afterSuperSam/TinyML-ESP32-CO2Prediction/docs/System.md

# 系统 System

## 当前能力与边界

当前源码 v1.12.1 使用 ESP32-S3、2.4 英寸横向触摸屏与 SCD41；上次板端验收版本为 v1.12.0。已实现实时读数、分钟历史、CO₂ TinyML 预测及持久化开关、双情景曲线、触摸校准、环境分类、LittleFS 记录和 USB 导出。

当前运行入口为实时采集，界面没有实测/回放模式切换按钮。保留的回放模块用于已有逻辑检查，不代表系统会在传感器故障时自动改用演示数据。

控制页只预览目标档位；尚未在运行固件中输出 GPIO17 PWM 或读取 GPIO18 TACH。未实现电池电量/充电管理、联网校时、SD 卡存储或实际闭环通风。风扇模拟不证明真实换气效果。

## 数据流程

```text
SCD41 → 约 5 秒原始读数 ───────────→ LittleFS 测量行
       → 一分钟均值 → 连续性检查 → TinyML +5/+15 预测
                                         ├─ 延续 / 风扇模拟曲线
                                         └─ LittleFS 预测快照
故障、恢复、启停、校时、心跳 ─────────→ LittleFS 事件行
LittleFS → USB → 带场次与状态字段的 CSV
```

每分钟至少 8 条成功读数且当分钟没有读取错误，才形成有效均值。连续有效历史达到 20 分钟才推理；无效分钟保留为缺口，不插值。读取错误或 15 秒没有新有效读数时，当前值显示异常；30 秒无有效读数后尝试恢复，每次间隔至少 30 秒。

传感器恢复保留历史和场次。预测失败不删除已保存原始记录，也不把旧实时读数继续显示为有效。

## 固件模块

所有源码直接位于 `firmware/`。

| 文件 | 职责 |
|---|---|
| firmware.ino | 唯一入口，调用启动与调度 |
| application.h | 协调传感器、预测、记录、触摸和绘图 |
| config.h / build.json | 运行参数及编译参数 |
| sensor.h | Wire 通信、CRC、测量状态、分钟汇总与恢复 |
| data.h | 当前读数、61 格历史和连续性检查 |
| predictor.h / model_assets.h | TFLite Micro、量化模型和预处理参数 |
| prediction.h | 模型状态与风扇情景计算 |
| recording.h / partitions.csv | 场次文件、刷盘、容量管理与导出 |
| clock.h | 可选 USB 时间锚点 |
| touch.h | XPT2046 读取、四角校准和 NVS 持久化 |
| display.h / canvas.h | SPI 显示、RGB565 画布与变化区域传输 |
| interface.h / widgets.h | 页面路由、事件分发和公用控件 |
| *_page.h | 主页、控制、设置、记录和调试页面 |
| font_assets.h | 界面字模 |
| replay.h / replay_assets.h | 既有回放数据与逻辑检查支持 |

`tools/firmware.py` 检查入口和构建配置后，直接使用 `firmware/` 调用 Arduino CLI；编译输出在 `.build/firmware/`。原有独立屏幕、风扇和模型测试入口已移除。

## 显示与触摸

画布为 320×240 RGB565，约 150 KiB；程序按 100 ms 间隔安排重绘。16×16 区域哈希减少静态像素传输，SPI 时钟为 8 MHz。调试页 fps 表示程序重绘次数，不是液晶面板扫描刷新率；不能保证每次完整画面都达到 10 fps。

触摸矩阵包含版本、分辨率、方向和校验和。仅有效矩阵可复用；校准存入独立 NVS 命名空间，不影响 LittleFS 日志。启动校准和设置页入口均保留。

## 时钟与环境

USB 校时保存真实时间与 64 位运行时长锚点；未校时时保留相对时间并允许记录。设备不恢复未知断电间隔。

环境值为 classroom、bedroom、outdoor、enclosed。场次开始时冻结环境，记录中无法切换。所有实时来源统一为 `classroom_measurement`，具体场所由 environment 区分；该 source 名称不意味着每场都在教室。

## 记录协议与可靠性

当前格式为 4，导出兼容格式 1–4。场次头保存设备标识、场次编号、来源、模型哈希、启动运行时长、环境和校时锚点。

| 记录 | 内容 |
|---|---|
| measurement | 每次已解码的新读数、有效状态、错误和当时预测 |
| sensor_fault / 恢复事件 | 通信、CRC、过期、零值、恢复过程等 |
| heartbeat | 每分钟的读数年龄、累计错误、恢复次数、空间与内存 |
| prediction_snapshot | 分钟结算或开关操作时的发布运行时长、末历史分钟、目标分钟、两种情景、状态、模型哈希和模拟参数 |
| minute_summary / prediction_enabled / prediction_disabled | 分钟成功样本数、错误数、失效原因，以及预测开关变化 |
| session_start / session_stop | 场次启停；启动包含复位原因 |
| clock_set / export_begin / export_end | 时间锚点变化与采样暂停边界 |

每条写入后 flush、关闭并检查长度。满盘或写入失败停止写入，不覆盖旧文件、不自动格式化。写入失败信息另存 NVS，下次成功开场时补记。断电可能造成最后一行不完整，导出跳过并报告数量；不能保证正在写入的末行已保存。

记录意图保存于 NVS：记录中重启后新建场次续记，主动停止后不自动开始。USB 导出是同步操作，会暂停采样；导出结束继续原场次，缺口不伪造补齐。

### 容量

当前 16MB 专用分区：NVS 0x9000/0x5000；应用槽 0x10000/0x140000 与 0x150000/0x140000；LittleFS 0x290000/0xD60000，约 13.375 MiB；coredump 0xFF0000/0x10000。实际可写量由文件系统开销和 16 KiB 预留空间共同决定。

原始读数约每 5 秒一条：一天约 17,280 条，两周约 241,920 条。仅按每条 100 字节计算，两周已约 23.1 MiB，超过现有日志分区；预测快照、故障及心跳还会占用空间。因此当前存储不能承诺无管理连续保留两周全部原始数据。长期实验需定期导出和管理容量，或后续增加存储；程序没有自动清理或循环覆盖。

## 配置与检查

GPIO、传感器周期、刷新、触摸、预测时距、风扇假设和空间预留集中在 `config.h`，通过静态断言检查。`build.json` 只含 fqbn 与 jobs，构建工具检查类型、开发板和取值范围。模型配置由 `model/data.py` 校验。

v1.11.1 已通过 Python 语法、配置与路径校验、记录导出兼容性、桌面页面逻辑、模型示例推理及 ESP32-S3 完整编译。程序 616,124 字节，静态内存 197,152 字节；本版尚未上传。桌面检查不证明物理触摸手感、真实通风效果或数天连续记录可靠性。

2026-10-12 v1.11.2 扩大 CO₂ 量化范围，训练权重、接线与分区保持不变。范围配置与桌面探针通过；完整编译程序仍为 616,124 字节，静态内存 197,152 字节；已上传 COM4 并通过写入哈希校验。板端返回新模型哈希 `12aafb97…`，未校时状态下读数为 748 ppm、传感器持续采样；存储挂载且记录继续，查询时保留 6 场、3,903 条记录。重启后历史尚不足 20 分钟，本轮未验证历史积累完成后的在线推理或高浓度实测准确度。[检查摘要](../.build/quantization-verification-v1.11.2.json) 与 [板端日志](../.build/quantization-board-v1.11.2.log) 分别保存桌面和板端证据。

## v1.12.0 验收

v1.12.0 按最终要求保留原双栏主页、原字体、状态胶囊和温度在上/湿度在下的顺序，仅删除顶部标题、时钟与“实测”栏，底部导航保留。设置页显示固件版本并可开关 TinyML；调试分为采样历史、模型性能和存储运行三页。

TinyML 开关保存到独立 NVS 配置，首次默认开启，重启后沿用。关闭立即清空预测并停止推理，继续采样、分钟汇总与原始记录；重新开启复用符合要求的历史。保存失败会显示中文错误并记录英文错误事件，不伪称持久化成功。预测状态 5 表示关闭，旧状态 0–4 不变；CSV 格式 4 支持状态 5，旧格式保持原语义。

Data 提供统一历史诊断；Sensor 在分钟结算时保留成功样本数、错误数与首个失效原因，写入 `minute_summary` 事件。串口 `s` 输出连续有效分钟、首个坏分钟及原因、当前分钟采样数、错误/恢复计数和读数年龄；`p` 与设置页共用预测开关动作。Application 汇集状态到 Interface 诊断快照，页面不直接访问硬件。

正常每分钟发布预测快照，开关操作额外发布状态快照；同分钟成功推理复用结果。图中预测从末完整分钟均值起始，纵轴覆盖低于 400 ppm 的有效数据，断序历史不连线。存储读写失败时记录页显示“请重启”，避免出现无效的开始按钮。模型、接线、分区及原始记录格式主体保持不变。

本轮独立静态审查覆盖非生成固件、模型和工具代码及文档；实际 320×240 页面已检查正常/关闭/缺口/故障、10000 ppm、负温度、100% 湿度和高浓度图轴。7 项 CSV 测试、真实核心函数的桌面验证、页面触摸路由与工程检查通过。完整固件编译通过，程序 636,884 字节、静态内存 198,072 字节；[编译日志](../.build/firmware-v1.12.0-compile.log) 和 [上传日志](../.build/firmware-v1.12.0-upload.log) 保存实际输出。

COM4 上传后写入哈希校验通过，分区文件 SHA256 与旧版一致。板端阶段检查均通过：[上传前](../.build/v1.12.0-board-before-20261012-220615-040758.json)、[新版状态](../.build/v1.12.0-board-status-20261012-220922-866567.json)、[关闭预测](../.build/v1.12.0-board-disable-20261012-221026-158769.json)、[重启保留](../.build/v1.12.0-board-after_reset-20261012-221200-311581.json)、[恢复开启](../.build/v1.12.0-board-enable-20261012-221232-049211.json)。关闭时状态为 5、四项预测为空，采样和记录继续；重启仍关闭、校准仍有效，并新建场次续记。最终恢复开启，模型哈希仍为 `12aafb97…`；场次计数 8→10、累计记录 6,125→6,216，未初始化或格式化存储。该检查核对状态与计数，未逐文件校验旧记录内容。

验收结束时连续有效历史为 1 分钟，无坏分钟及采样错误，正在重新积累 20 分钟窗口。本轮未再次等待窗口完整后的在线推理，也未验证真实屏幕触摸手感或长时稳定性；桌面渲染和主机模拟不代替这些实物证据。

历史缺口的只读证据：2026-10-12 19:58–19:59，v1.11.2 返回历史 26→27 分钟但预测 status=2，当前采样和记录正常；21:14 再查已恢复 status=0，+5/+15 分钟为 785.13/833.44 ppm，推理 184 μs。只能确认缺口自行消失，无法回溯具体坏分钟原因。v1.12.0 增加诊断证据，不插值、不降低每分钟至少 8 条且无错误的质量要求，也不宣称已修复未经确认的传感器故障。

## USB 导出检查

2026-10-13 记录开启时的三次全量导出均未收到结束标记。主机改为块读取、原始流落盘后再解析，独立审查和 13 项针对性测试通过，但实机中断仍存在。第三次 [原始日志](../.build/recording-export-b7wd_fun.raw.log) 显示数据尚未传完便恢复实时采样；[临时 CSV](../data/co2-recording-2026-10-13-all.csv.partial) 仅含 2,597 条，不是完整备份。证据符合固件 USB 连接判断提前退出的路径，具体触发原因尚未确认。

13:23 的 [状态检查](../.build/v1.12.0-board-status-20261013-132314-063113.json) 显示 14 场、19,543→19,544 条，采样和写入继续；未发送复位、初始化或擦除命令。

用户暂停记录后再次导出仍超时：[原始日志](../.build/recording-export-gmdlaz6_.raw.log) 未包含结束标记，[临时 CSV](../data/co2-recording-2026-10-13-paused-132703.csv.partial) 仅 3,382 条，因此暂停记录不能消除该中断。13:29 的 [只读检查](../.build/paused-recording-status-20261013-132945.json) 确认存储挂载、记录保持停止（active=false），板上共 14 场、19,588 条；传感器继续采样且未报告错误。此次未恢复记录、复位或擦除数据。

## 2026-10-23 完整审查

基准为本地 `b88020f` 干净快照，覆盖非生成固件、模型与工具代码、模型产物契约、README 和三份文档、实际离线页面渲染。审查未修改实现，未连接或复位设备，未执行发布构建。Instruction 只维护操作说明。

| 轴 | 级别 | 问题与影响 | 建议 |
|---|---|---|---|
| 实现可靠性 | P1 | `firmware/recording.h:295` 在 USB 状态一次为 false 时直接退出导出，没有结束标记；离线探针复现，主机最终超时。实际设备的瞬变触发原因仍待确认 | 对连接暂态做有界等待，检查发送长度并明确报告失败 |
| 需求与界面 | P3 | `firmware/recording_page.h:31` 在主动停止后仍显示“USB 导出后自动继续记录”，与实际保持停止不符 | 按记录状态分别显示提示 |
| 文档可复现性 | P2 | 本节新增前，系统文档中有 15 个证据链接指向被 Git 忽略的 `.build/` 或设备数据；本机存在，新克隆仓库不存在 | 将必要验证摘要纳入仓库，并明确原始日志只在本机保留；不公开原始设备数据来填补链接 |

13 项主机导出测试、核心 C++ 回归和实际界面渲染检查通过。核心回归覆盖 NVS、停止恢复、CRC/读数过期、分钟缺口、推理去重、满盘与半写保护。补充探针证明 USB 早退会产生开始标记但没有结束标记，完整缺失分钟不会被放行用于预测。主页双栏、原字体、顶部栏删除、TinyML 关闭画面和三页调试符合最终需求；未见高浓度、负温度或高湿度画面遮挡。通过这些检查不代表已修复 USB 故障，也不证明物理屏幕手感或长期运行可靠性。

历史数据核验：在副本上解包 `data/littlefs-20261013-135100.bin`，得到 14 个场次文件、19,588 条完整记录；每个文件末尾完整、场内序号连续，格式 3/4 混合数据通过现有解析器校验。镜像 SHA256 为 `0edb5c099c05719da9659aae7584a54801caf9f995f2fe667a0befa60eb825e1`，原镜像未改动。全部场次未校时，不能据此恢复真实采集日期。此结论仅针对 2026-10-13 的本机镜像，不代表当前板端数据，也不证明 USB 导出已完成。

本机审查产物位于 `.build/audit-littlefs-20261023-report.json`、`.build/audit-firmware-probes/` 和 `.build/ui-frames/review-spec-contact.png`，均不随仓库分发；关键结论已记录于上文。

镜像离线恢复的历史 CSV 已另存为本机 `data/co2-recording-recovered-2026-10-13.csv`，共 19,588 条（含 16,302 条测量、1,058 条预测快照和其余事件）。CSV SHA256 为 `5e19c5895356ce107b1f8448deed66a5c027295c251dd0eccb3dd458f99c9b35`；它不是 2026-10-23 的设备导出，原镜像和之前的临时文件均保留。

模型与工具审查未确认新增 P1/P2 问题：日期划分先于建窗，标准化与数据校准窗口只取训练集；当前模型和独立候选的 TFLite、各自固件头文件及 metadata 哈希一致，配置快照及当前回放哈希一致。现有示例推理通过，当前 537.33 ppm 时输出 +5 分钟 539.25、+15 分钟 542.84 ppm；这只是公开数据上的链路检查，不是实测准确度验证。TensorFlow 发出解释器弃用警告，本轮未因此更换依赖。

## v1.12.1 USB 导出处理

源码修复连接状态一次为 false 就立即退出的问题。开始标记、场次头、观测/预测行和结束标记共用发送函数；连接或发送暂不可用时保留偏移，连续 3 秒无进展才中止。每块不超过当前可写空间和 64 字节，短写按实际接受字节续传；正常发送只让出调度，无进展时等待 5 毫秒。参数集中在 `config.h` 并静态校验。

中止时保留 `export_aborted` 事件，并尝试发送 `usb_export_timeout` 错误；完全断连时错误可能无法送达，主机仍会超时。主机收到明确错误就结束采集并保留原始流和 `.partial`；半截 JSON 不会阻止继续保存错误信息，但离线完整性校验仍拒绝损坏记录，不能凭一个结束标记生成正式 CSV。记录开关意图、旧记录、模型、分区和格式版本不变。

DTR/RTS 假设已按本机 ESP32 `3.3.10-cn` 的 HWCDC 源码核对：当前 `USBMode=hwcdc` 的连接布尔值来自 `isPlugged()` 与连接状态，并无 DTR/RTS 直接门控条件。主机保留控制线为 false，不能将其直接认定为实机中断根因。此结论不适用于不同的 USB CDC 实现，也不能证明设备上库二进制与本机源码完全一致。

本机 HWCDC 在部分断连路径会替换发送队列并仍报告原长度，`flush()` 也可能清空队列，因此本修复不调用 `Serial.flush()`，不把写入返回当成交付确认。连接/空闲空间检查与实际写入之间仍有状态变化窗口；严格端到端无损保证需要底层可靠写入或另行设计确认重传协议。本版先处理应用层早退与正常短写，P1 实机验收未关闭。

2026-10-24 离线验证：新增回归在原实现下失败，修复后 14 项主机测试、核心回归及 8 种 USB 场景通过，包括短暂/持续断连、短写、零进展、首部/末尾恢复与已停止记录。独立审查额外确认半截 JSON 后即使出现合法结束标记也不能误报成功。ESP32 固件编译通过，程序 637,300 字节，静态内存 198,072 字节。未访问设备、未更改 Arduino 平台源码；原始红/绿测试日志位于本机 `.build/usb-p1-red.log` 与 `.build/usb-p1-green.log`，编译日志为 `.build/firmware-v1.12.1-compile.log`，不随仓库分发。

复核用语：空的回放 `sample_origin` 会导致入口捕获并报告导出失败；含逗号且未经转义的 detail 会被字段数校验拒绝，均不是静默错位。公开数据 20,560 行的直接计数证据是 `model/artifacts/co2/data_audit.json`；独立合成数据对应审计文件记录 22,500 行。
