afterSuperSam/TinyML-ESP32-CO2Prediction/model/artifacts/co2/test_predictions.csv

origin_timestamp | current_ppm | actual_5 | actual_15 | persistence_5 | persistence_15 | ridge_5 | ridge_15 | mlp_float_5 | mlp_float_15 | mlp_int8_5 | mlp_int8_15 | input_saturated
2015-02-15T00:19:00 | 537.3333129882812 | 537.0 | 541.3333 | 537.3333 | 537.3333 | 535.9267771854217 | 535.7703369375029 | 539.05896 | 541.12213 | 539.2493 | 542.8421 | 0
2015-02-15T00:20:00 | 534.0 | 538.0 | 536.5 | 534.0 | 534.0 | 532.5822124699708 | 532.017390905012 | 535.71686 | 537.0057 | 535.916 | 536.54346 | 0
2015-02-15T00:21:00 | 534.0 | 538.0 | 541.0 | 534.0 | 534.0 | 533.5500614685456 | 532.0710988697311 | 535.7567 | 537.3837 | 535.916 | 536.54346 | 0
2015-02-15T00:22:00 | 538.0 | 544.5 | 537.5 | 538.0 | 538.0 | 535.8606896427453 | 534.864572470897 | 539.4532 | 541.77747 | 539.916 | 540.54346 | 0
2015-02-15T00:23:00 | 534.5 | 542.0 | 532.5 | 534.5 | 534.5 | 533.4567775763084 | 533.146101911529 | 536.3747 | 538.5288 | 538.4733 | 540.0088 | 0
2015-02-15T00:24:00 | 537.0 | 542.0 | 537.0 | 537.0 | 537.0 | 535.4530247341792 | 535.7351379741554 | 539.08673 | 541.15485 | 540.9733 | 542.5088 | 0
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
