afterSuperSam/TinyML-ESP32-CO2Prediction/model/artifacts/rapid-rise/test_predictions.csv

origin_timestamp | current_ppm | actual_5 | actual_15 | persistence_5 | persistence_15 | ridge_5 | ridge_15 | mlp_float_5 | mlp_float_15 | mlp_int8_5 | mlp_int8_15 | input_saturated
2026-05-01T00:19:00 | 1193.322509765625 | 1172.0084 | 1333.209 | 1193.3225 | 1193.3225 | 1175.3675489475531 | 1138.8193555053826 | 1156.4685 | 1090.0255 | 1152.9116 | 1087.0917 | 0
2026-05-01T00:20:00 | 1190.8094482421875 | 1179.7821 | 1356.7655 | 1190.8094 | 1190.8094 | 1173.1910406347056 | 1137.4411577372111 | 1155.2759 | 1090.5889 | 1150.3986 | 1084.5786 | 0
2026-05-01T00:21:00 | 1177.556640625 | 1170.5087 | 1396.849 | 1177.5566 | 1177.5566 | 1151.4515476363945 | 1105.253300412797 | 1136.6545 | 1067.5082 | 1134.4099 | 1056.6804 | 0
2026-05-01T00:22:00 | 1194.8994140625 | 1174.4661 | 1414.32 | 1194.8994 | 1194.8994 | 1187.2442307977788 | 1161.7069104890682 | 1160.1842 | 1096.8987 | 1157.2245 | 1088.6686 | 0
2026-05-01T00:23:00 | 1177.2586669921875 | 1170.3912 | 1454.3712 | 1177.2587 | 1177.2587 | 1162.3869132073767 | 1127.76078730085 | 1138.1707 | 1075.0653 | 1136.8478 | 1071.0278 | 0
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
