afterSuperSam/TinyML-ESP32-CO2Prediction/model/artifacts/co2/example_history.csv

timestamp | co2_ppm | temperature_c | humidity_pct | valid
2015-02-15T00:00:00 | 535.5 | 19.89 | 35.745 | 1
2015-02-15T00:01:00 | 541.0 | 19.89 | 35.7 | 1
2015-02-15T00:02:00 | 539.3333 | 20.0 | 35.7 | 1
2015-02-15T00:03:00 | 541.0 | 20.0 | 35.7 | 1
2015-02-15T00:04:00 | 542.0 | 20.0 | 35.7 | 1
2015-02-15T00:05:00 | 540.0 | 19.926666 | 35.7 | 1
2015-02-15T00:06:00 | 532.0 | 20.0 | 35.7 | 1
2015-02-15T00:07:00 | 534.0 | 19.945 | 35.7 | 1
2015-02-15T00:08:00 | 537.0 | 20.0 | 35.7 | 1
2015-02-15T00:09:00 | 542.0 | 19.926666 | 35.7 | 1
2015-02-15T00:10:00 | 538.5 | 20.0 | 35.7 | 1
2015-02-15T00:11:00 | 538.0 | 19.89 | 35.645 | 1
2015-02-15T00:12:00 | 540.75 | 19.9175 | 35.7 | 1
2015-02-15T00:13:00 | 539.0 | 20.0 | 35.7 | 1
2015-02-15T00:14:00 | 529.3333 | 19.963333 | 35.663334 | 1
2015-02-15T00:15:00 | 534.5 | 20.0 | 35.59 | 1
2015-02-15T00:16:00 | 536.0 | 20.0 | 35.59 | 1
2015-02-15T00:17:00 | 531.0 | 20.0 | 35.59 | 1
2015-02-15T00:18:00 | 531.5 | 20.0 | 35.59 | 1
2015-02-15T00:19:00 | 537.3333 | 20.0 | 35.59 | 1
