afterSuperSam/TinyML-ESP32-CO2Prediction/model/artifacts/rapid-rise/example_history.csv

timestamp | co2_ppm | temperature_c | humidity_pct | valid
2026-05-01T00:00:00 | 1226.8964 | 29.558506 | 61.06206 | 1
2026-05-01T00:01:00 | 1223.2555 | 29.575428 | 61.085297 | 1
2026-05-01T00:02:00 | 1224.1451 | 29.553144 | 60.977337 | 1
2026-05-01T00:03:00 | 1229.0288 | 29.565432 | 60.865044 | 1
2026-05-01T00:04:00 | 1225.6467 | 29.581469 | 60.997414 | 1
2026-05-01T00:05:00 | 1219.2684 | 29.52534 | 61.02481 | 1
2026-05-01T00:06:00 | 1219.57 | 29.614332 | 60.963654 | 1
2026-05-01T00:07:00 | 1225.562 | 29.565485 | 60.74529 | 1
2026-05-01T00:08:00 | 1216.5271 | 29.573458 | 60.975384 | 1
2026-05-01T00:09:00 | 1212.6456 | 29.538628 | 60.7791 | 1
2026-05-01T00:10:00 | 1217.2457 | 29.595806 | 60.9887 | 1
2026-05-01T00:11:00 | 1213.8788 | 29.591661 | 60.970844 | 1
2026-05-01T00:12:00 | 1210.7877 | 29.564531 | 60.88727 | 1
2026-05-01T00:13:00 | 1208.7982 | 29.582691 | 60.980618 | 1
2026-05-01T00:14:00 | 1211.9479 | 29.546936 | 60.77555 | 1
2026-05-01T00:15:00 | 1207.2854 | 29.58477 | 60.8493 | 1
2026-05-01T00:16:00 | 1206.5452 | 29.583858 | 60.771877 | 1
2026-05-01T00:17:00 | 1202.0557 | 29.59661 | 60.978725 | 1
2026-05-01T00:18:00 | 1196.6907 | 29.540089 | 60.689396 | 1
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
