afterSuperSam/TinyML-ESP32-CO2Prediction/firmware/model_assets.h

#pragma once
#include <stdint.h>
// 此文件由 model/train.py 生成，模型、预处理和回放样本保持同版。
namespace ModelAssets {
alignas(16) const unsigned char model[] = {
0x20, 0x00, 0x00, 0x00, 0x54, 0x46, 0x4c, 0x33, 0x00, 0x00, 0x00, 0x00, 0x14, 0x00, 0x20, 0x00,
0x1c, 0x00, 0x18, 0x00, 0x14, 0x00, 0x10, 0x00, 0x0c, 0x00, 0x00, 0x00, 0x08, 0x00, 0x04, 0x00,
0x14, 0x00, 0x00, 0x00, 0x1c, 0x00, 0x00, 0x00, 0x1c, 0x00, 0x00, 0x00, 0x74, 0x00, 0x00, 0x00,
0xfc, 0x06, 0x00, 0x00, 0x0c, 0x07, 0x00, 0x00, 0x4c, 0x0d, 0x00, 0x00, 0x03, 0x00, 0x00, 0x00,
0x00, 0x00, 0x00, 0x00, 0x02, 0x00, 0x00, 0x00, 0x34, 0x00, 0x00, 0x00, 0x04, 0x00, 0x00, 0x00,
0xdc, 0xff, 0xff, 0xff, 0x0c, 0x00, 0x00, 0x00, 0x04, 0x00, 0x00, 0x00, 0x13, 0x00, 0x00, 0x00,
0x43, 0x4f, 0x4e, 0x56, 0x45, 0x52, 0x53, 0x49, 0x4f, 0x4e, 0x5f, 0x4d, 0x45, 0x54, 0x41, 0x44,
0x41, 0x54, 0x41, 0x00, 0x08, 0x00, 0x0c, 0x00, 0x08, 0x00, 0x04, 0x00, 0x08, 0x00, 0x00, 0x00,
0x0b, 0x00, 0x00, 0x00, 0x04, 0x00, 0x00, 0x00, 0x13, 0x00, 0x00, 0x00, 0x6d, 0x69, 0x6e, 0x5f,
0x72, 0x75, 0x6e, 0x74, 0x69, 0x6d, 0x65, 0x5f, 0x76, 0x65, 0x72, 0x73, 0x69, 0x6f, 0x6e, 0x00,
0x0d, 0x00, 0x00, 0x00, 0x84, 0x06, 0x00, 0x00, 0x7c, 0x06, 0x00, 0x00, 0x64, 0x06, 0x00, 0x00,
0x2c, 0x06, 0x00, 0x00, 0xdc, 0x05, 0x00, 0x00, 0xcc, 0x03, 0x00, 0x00, 0x3c, 0x03, 0x00, 0x00,
0xac, 0x00, 0x00, 0x00, 0xa4, 0x00, 0x00, 0x00, 0x9c, 0x00, 0x00, 0x00, 0x94, 0x00, 0x00, 0x00,
0x74, 0x00, 0x00, 0x00, 0x04, 0x00, 0x00, 0x00, 0xce, 0xf9, 0xff, 0xff, 0x04, 0x00, 0x00, 0x00,
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
{6.271087036e+02f, 6.268281250e+02f},
{7.302440796e+02f, 7.281474609e+02f},
{1.011129395e+03f, 1.001286133e+03f},
{7.175253906e+02f, 7.172448120e+02f},
{9.441293945e+02f, 9.342861328e+02f},
{1.758858643e+03f, 1.749682129e+03f},
{1.434124023e+03f, 1.409695435e+03f}
};
}
