afterSuperSam/TinyML-ESP32-CO2Prediction/firmware/replay_assets.h

#pragma once
#include <math.h>
#include <stdint.h>
// 由 model/export_replay.py 生成；连续公开实测和桌面参考值，不是实时采集。
namespace ReplayAssets {
constexpr unsigned count = 720;
constexpr unsigned startMinuteOfDay = 480;
constexpr char date[] = "2015-02-17";
constexpr char modelSha256[] = "12aafb9717b430f24806ff4df01e2304d1802ec5f7ab6d131f463860dc44454b";
constexpr float samples[count][3] = {
{7.765000000e+02f, 2.060000038e+01f, 3.038999939e+01f},
{7.745000000e+02f, 2.060000038e+01f, 3.038999939e+01f},
{7.730000000e+02f, 2.060000038e+01f, 3.038999939e+01f},
{7.730000000e+02f, 2.060000038e+01f, 3.038999939e+01f},
{7.820000000e+02f, 2.060000038e+01f, 3.038999939e+01f},
{7.845000000e+02f, 2.060000038e+01f, 3.038999939e+01f},
{7.820000000e+02f, 2.060000038e+01f, 3.038999939e+01f},
{7.813333130e+02f, 2.060000038e+01f, 3.038999939e+01f},
{7.830000000e+02f, 2.070000076e+01f, 3.050000000e+01f},
{7.906666870e+02f, 2.060000038e+01f, 3.038999939e+01f},
{7.896666870e+02f, 2.060000038e+01f, 3.038999939e+01f},
{7.870000000e+02f, 2.060000038e+01f, 3.038999939e+01f},
{7.833333130e+02f, 2.060000038e+01f, 3.038999939e+01f},
{7.815000000e+02f, 2.060000038e+01f, 3.038999939e+01f},
{7.795000000e+02f, 2.060000038e+01f, 3.038999939e+01f},
{7.790000000e+02f, 2.060000038e+01f, 3.038999939e+01f},
{7.880000000e+02f, 2.060000038e+01f, 3.038999939e+01f},
{7.890000000e+02f, 2.060000038e+01f, 3.038999939e+01f},
{7.850000000e+02f, 2.060000038e+01f, 3.038999939e+01f},
{7.830000000e+02f, 2.060000038e+01f, 3.038999939e+01f},
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
{0, 8.295513916e+02f, 8.313281250e+02f},
{0, 8.318013916e+02f, 8.335781250e+02f},
{0, 8.393587036e+02f, 8.420434570e+02f},
{0, 8.401087036e+02f, 8.427934570e+02f},
{0, 8.348587036e+02f, 8.345781250e+02f},
{0, 8.393587036e+02f, 8.420434570e+02f},
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
};
#endif
}
