afterSuperSam/TinyML-ESP32-CO2Prediction/(commit log)

2026-10-13 chore: 初始化 TinyML CO2 预测项目
    [environment.csv, example_history.csv, partitions.csv, test_predictions.csv, ui_replay_reference.csv]
2026-10-13 docs: 精简公开仓库内容
2026-10-13 fix: 补全训练数据集
    [environment.csv]
2026-10-23 docs: 更新完整审查结论与历史数据恢复结果
2026-10-24 fix: 修复 USB 导出早退与短写处理
    [config.h, export_recording.py, recording.h, verify_recording.py]
